TheNeoBurn/KidsPatch_ShiftRegisterPWM/animations.h

const uint32_t ANI_HEART[] PROGMEM = {
  13,
  //PPPPPPP|---||---||---||---||---|
  0b11111110010001110111111111101010,
  0b00111110010001110111111111101010,
  0b00001110010001110111111111101010,
  0b00111110010001110111111111101010,
  0b11111110010001110111111111101010,
  0b11111110000000100011100101000000,
  0b11111110000000000001000000000000,
  0b00111110000000000001000000000000,
  0b00001110000000000001000000000000,
  0b00000000000000000001000000000000,
  0b00001110000000000001000000000000,
  0b00111110000000100011100101000000,
  0b01111110010001110111111111101010
};

const uint32_t ANI_NARUTO_L[] PROGMEM = {
  5,
  0b1000001111010001011010001,
  0b1000001111010001011001000,
  0b1000001111010000110001000,
  0b1000001111010001100001100,
  0b1000001111010001010010010
};

const uint32_t ANI_NARUTO_R[] PROGMEM = {
  5,
  0b0000111110000100110110001,
  0b0000111110000100110100010,
  0b0000111110000100011000010,
  0b0000111110000100001100110,
  0b0000111110000100011101001
};

const uint32_t ANI_KAMI[] PROGMEM = {
  12,
  0b0010001100101000010001010, 
  0b0010000100011000010001010, 
  0b0010000100001100010001010, 
  0b0010000100001100010001010, 
  0b0010000110001110010001010, 
  0b0100001100011110100010100, 
  0b1000011000111011000001000, 
  0b0000010000110010000010000, 
  0b0000000000100010000000000, 
  0b0000000000000010000000000, 
  0b0000000000000100000000000, 
  0b0000000000001000000000000
};

const uint32_t ANI_BOOM[] PROGMEM = {
  8,
  0b0000000100011100010000000, 
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
  0b0000000000000000001000000,
  0b0000000000000000010000000,
  0b0000000000000000100000000,
  0b0000000000100000000000000,
  0b0000000000010000000000000,
  0b0000000100000000000000000,
  0b0000000010000000000000000,
  0b0000100000000000000000000,
  0b0001000000000000000000000
};
