TheNeoBurn/KidsPatch_ShiftRegisterPWM/chars.c

#include <stdint.h>

uint32_t getAniChar(char c) {
  switch (c) {
    case 'A':  return  0b1000111111100010101000100;
    case 'B':  return  0b1111010001111101000111110;
    case 'C':  return  0b0111110000100001000001111;
    case 'D':  return  0b1111010001100011000111110;
    case 'E':  return  0b1111110000111001000011111;
    case 'F':  return  0b1000010000111001000011111;
    case 'G':  return  0b0111110001100111000001111;
    case 'H':  return  0b1000110001111111000110001;
    case 'I':  return  0b1111100100001000010011111;
    case 'J':  return  0b0111010001000010000111111;
    case 'K':  return  0b1000110010111001001010001;
    case 'L':  return  0b1111110000100001000010000;
    case 'M':  return  0b1000110001101011101110001;
    case 'N':  return  0b1000110011101011100110001;
    case 'O':  return  0b0111010001100011000101110;
    case 'P':  return  0b1000010000111101000111110;
    case 'Q':  return  0b0111110011101011000101110;
    case 'R':  return  0b1000110010111101000111110;
    case 'S':  return  0b1111000001011101000001111;
    case 'T':  return  0b0010000100001000010011111;
    case 'U':  return  0b0111010001100011000110001;
    case 'V':  return  0b0010001010010101000110001;
    case 'W':  return  0b1000111011101011000110001;
    case 'X':  return  0b1000101010001000101010001;
    case 'Y':  return  0b0010000100001000101010001;
    case 'Z':  return  0b1111101000001000001011111;
//    case 'Ä':  return  0b1000111111010100010010001;
//    case 'Ö':  return  0b0111010001100010111010001;
//    case 'Ü':  return  0b0111010001100010000010001;
    case '0':  return  0b0111010001101011000101110;
    case '1':  return  0b1111100100001001010001100;
    case '2':  return  0b1111101000001101000101110;
    case '3':  return  0b1111000001001100000111110;
    case '4':  return  0b0001011111100100101000110;
    case '5':  return  0b1111000001111101000011111;
    case '6':  return  0b0111010001111101000001110;
    case '7':  return  0b0010000100000100000111111;
    case '8':  return  0b0111010001011101000101110;
    case '9':  return  0b0111000001011111000101110;
    case '.':  return  0b0010000000000000000000000;
    case ',':  return  0b0100000100000000000000000;
    case '&':  return  0b0110110010011011001001100;
    case '-':  return  0b0000000000111110000000000;
    case '/':  return  0b1000001000001000001000001;
    case '+':  return  0b0010000100111110010000100;
    case '"':  return  0b0000000000000000101001010;
    case '´':  return  0b0000000000000000100000100;
    case '?':  return  0b0010000000001101000101110;
    case '!':  return  0b0010000000001000111001110;
    case ':':  return  0b0000000100000000010000000;
//    case '~':  return  0b1010100000000000000000000;
    case '_':  return  0b1111100000000000000000000;
    case '#':  return  0b0101011111010101111101010;
//    case ';':  return  0b0100000100000000010000000;
    case '(':  return  0b0001000100001000010000010;
    case ')':  return  0b0100000100001000010001000;
//    case '[':  return  0b0011000100001000010000110;
//    case ']':  return  0b0110000100001000010001100;
//    case '{':  return  0b0011000100010000010000110;
//    case '}':  return  0b0110000100000100010001100;
    case '<':  return  0b0001000100010000010000010;
    case '>':  return  0b0100000100000100010001000;
//    case '%':  return  0b1001101011001001101011001;
    case '=':  return  0b0000011111000001111100000;
//    case '\\': return  0b0000100010001000100010000;
//    case '^':  return  0b0000000000100010101000100;
//    case '°':  return  0b0000000000001000101000100;
    default:   return  0b0000000000000000000000000;
  }
}
